hbmartin/usb-c-cable-bracelet-double-sided-connector/generated/v8/concepts.md

# #3F Compact tapered 15° right-angle press-fit (standard)

13.6 × 27.2 × 9.198 mm; tapered outer flanks; inverted 15° center bend.

Push each plug along its straight axis from opposite ends, with cable tails outward. The inverted 15° middle bend has −7.5° / +7.5° section rolls; insertion axes remain parallel. Capture 2 mm of black base, leaving 0.5 mm to the silver elbow.

Same local sockets and trial mouth fits as #3E Inverted, with a 13.6 mm body and tapered outer flanks. Reuse the straight fit samples; physical retention and wrist comfort require a print test.
