hbmartin/usb-c-cable-bracelet-double-sided-connector/generated/v6/concepts.md

# #3E 15° right-angle side-by-side press-fit

Measured plug: 8.10 × 2.30 × 8.40 mm metal; 9.90 × 4.70 × 2.50 mm black base.
2 mm base capture; 0.5 mm silver-elbow standoff; 11.2 mm blind pocket.
15° bend between lanes about X: pod rolls +7.5° / −7.5°; insertion axes remain parallel. Mirror cable tails outward.
Print on negative-X end, −90° Y; A1 / PLA / 0.4 / 0.20 mm / Textured PEI.
20% gyroid, 3 walls, 5 top/bottom layers, 1 mm shells, no supports.
One centered holder.
Test gentle first. Retention and durability require physical testing; stop if force or cracking occurs.

## #3E 15° right-angle side-by-side press-fit (standard)

Mouth: (9.6, 4.4) mm; dimensions: (14.6, 27.2, 9.198) mm.
STEP: `step/03e_right_angle_side_by_side_standard.step`; STL: `stl/03e_right_angle_side_by_side_standard.stl`.
