hbmartin/usb-c-cable-bracelet-double-sided-connector/generated/v3/concepts.md

# #3B 15° curved press-fit

Body: 24.0 × 17.0 × 9.777 mm. 15° total bend; each straight socket tilts 7.5°. The concave underside faces the wrist.

Finished centerline arc radius: 6.075 mm. Minimum central pocket separation: 1.201 mm.

The winning #3 mouth, cavity, 0.8 mm throat, relief slots, 10.8 mm pocket depth, and 3.2 mm housing capture are preserved in each socket's local frame.

Push each plug straight along its tilted socket axis toward the center. Wear with the concave underside toward the wrist.

Print on the flat long side: the original 17 mm width becomes print height. A1 / Generic PLA / 0.4 mm / 0.20 mm Standard / Textured PEI; supports disabled.

Physical acceptance: retain #3's fit, improve wrist seating, and show no central cracking or separation during insertion. Grip, comfort and fatigue require a physical print test.
