hbmartin/usb-c-cable-bracelet-double-sided-connector/generated/v5/concepts.md

# #3D 15° curved side-by-side press-fit

Body: 15.2 × 30.0 × 9.774 mm. Concave wrist face, convex outer face; local radial thickness 9.4 mm.

Centerline radius: 53.901 mm. Socket lanes: ±6.5 mm; 7.5° tilt each, 15° total. The sockets remain straight and open from opposite ends.

Wear the concave underside toward the wrist. Push each plug straight along its own 7.5° tilted axis; the two offset sockets open from opposite ends.

Reference #3 fit: metal 8.65 × 2.95 mm; housing 12.20 × 6.60 mm; mouth 11.25 × 5.65 mm; 10.8 mm blind pocket, 3.2 mm capture, 0.8 mm nominal throat with 0.15 mm overlap, and unchanged 0.8 mm relief slots. All dimensions are measured in the socket's local frame.

Minimum inter-lane void separation: 1.225 mm; enclosed wall: 0.800 mm; closed end wall: 3.137 mm.

Print on the flat negative-X end face, rotated −82.5° about Y. Center: (128,128) mm. A1 / Generic PLA / 0.4 mm / 0.20 mm Standard / Textured PEI; no supports; 20% gyroid, 3 walls, 5 top and bottom layers with 1 mm shell thickness.

Physical acceptance: both plugs retain #3's usable fit independently, the curve seats comfortably on the wrist, and insertion causes no cracking or separation. These require a physical print test.
