hbmartin/usb-c-cable-bracelet-double-sided-connector/generated/v6/fit_samples/concepts.md

# #3E right-angle plug fit samples

Measured plug: 8.10 × 2.30 × 8.40 mm metal; 9.90 × 4.70 × 2.50 mm black base.
2 mm base capture; 0.5 mm silver-elbow standoff; 11.2 mm blind pocket.
Straight single-socket fit blocks.
Print on negative-X end, −90° Y; A1 / PLA / 0.4 / 0.20 mm / Textured PEI.
20% gyroid, 3 walls, 5 top/bottom layers, 1 mm shells, no supports.
Samples left to right: gentle, standard, firm; 12 mm gaps.
Test gentle first. Retention and durability require physical testing; stop if force or cracking occurs.

## #3E gentle fit sample

Mouth: (9.75, 4.55) mm; dimensions: (14.6, 14.4, 7.6) mm.
STEP: `step/03e_fit_sample_gentle.step`; STL: `stl/03e_fit_sample_gentle.stl`.

## #3E standard fit sample

Mouth: (9.6, 4.4) mm; dimensions: (14.6, 14.4, 7.6) mm.
STEP: `step/03e_fit_sample_standard.step`; STL: `stl/03e_fit_sample_standard.stl`.

## #3E firm fit sample

Mouth: (9.45, 4.25) mm; dimensions: (14.6, 14.4, 7.6) mm.
STEP: `step/03e_fit_sample_firm.step`; STL: `stl/03e_fit_sample_firm.stl`.
