hbmartin/usb-c-cable-bracelet-double-sided-connector/generated/all_connectors_preview.png

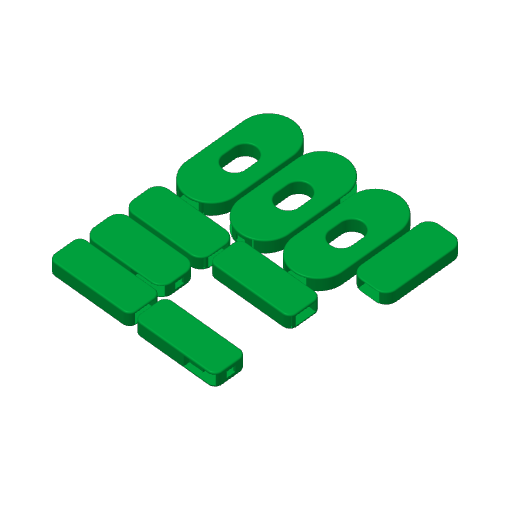
generated/all_connectors_preview.png
