hbmartin/usb-c-cable-bracelet-double-sided-connector/generated/v8/bend_section.png

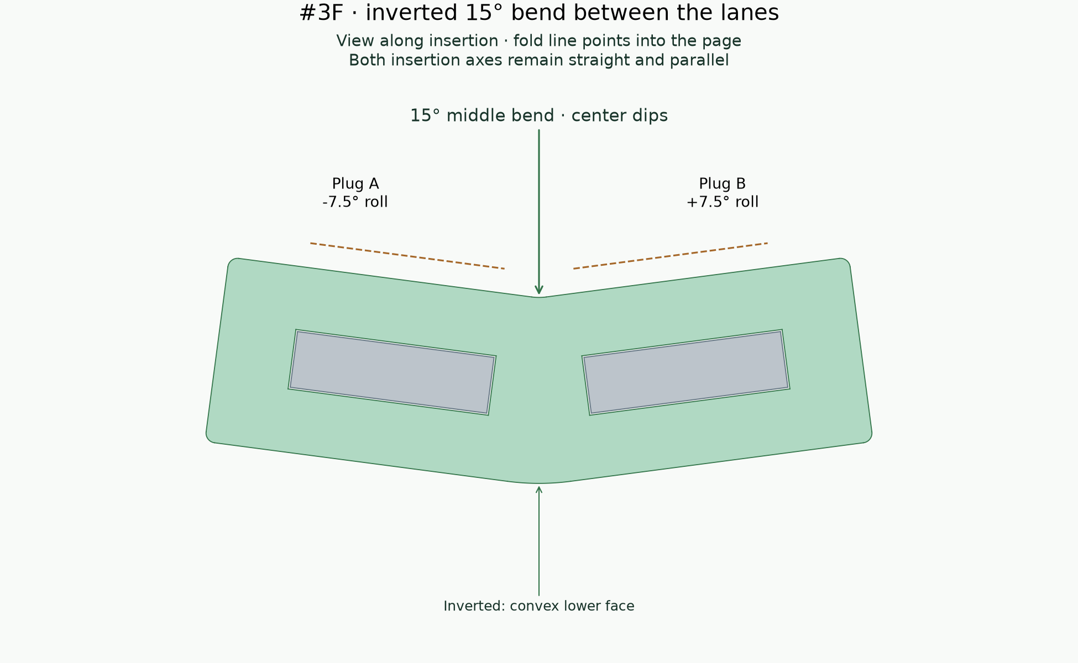
generated/v8/bend_section.png
