hbmartin/usb-c-cable-bracelet-double-sided-connector/generated/v8/comparison.png

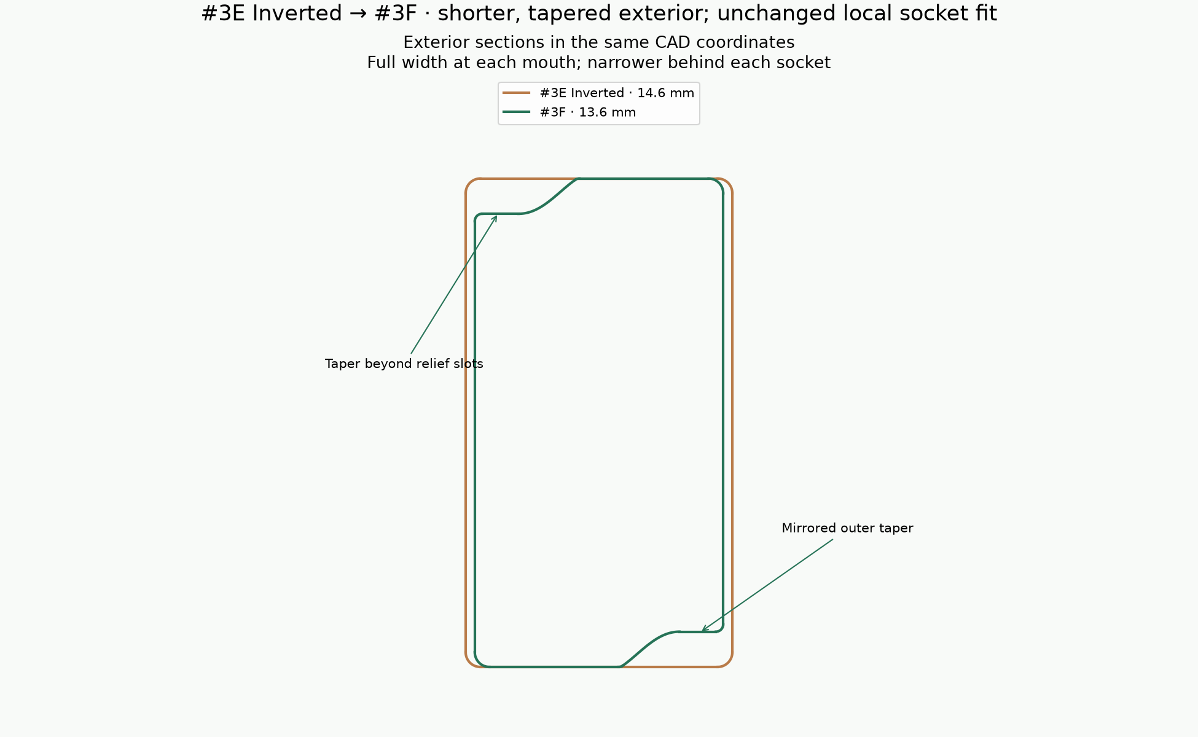
generated/v8/comparison.png
