hbmartin/usb-c-cable-bracelet-double-sided-connector/generated/v8/layer_paths.png

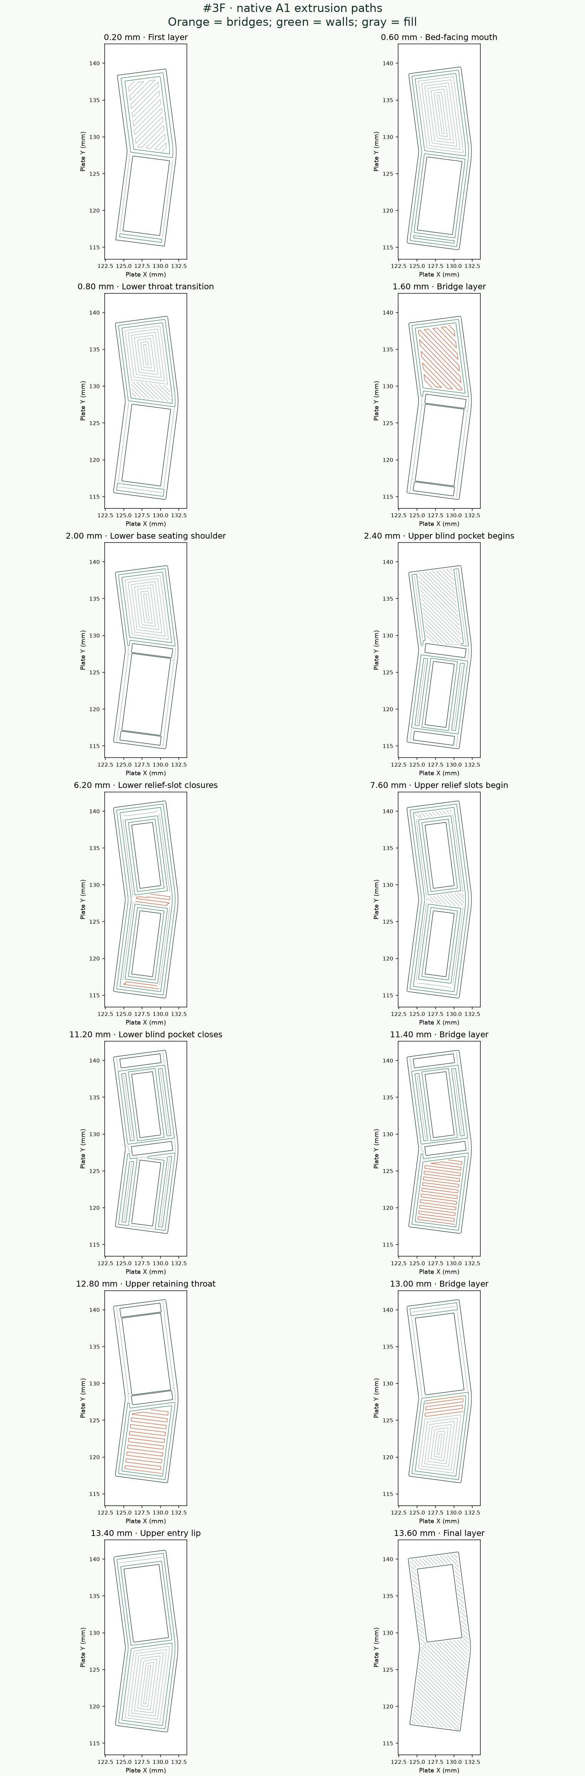
generated/v8/layer_paths.png
