hbmartin/usb-c-cable-bracelet-double-sided-connector/generated/v8/plate_map.png

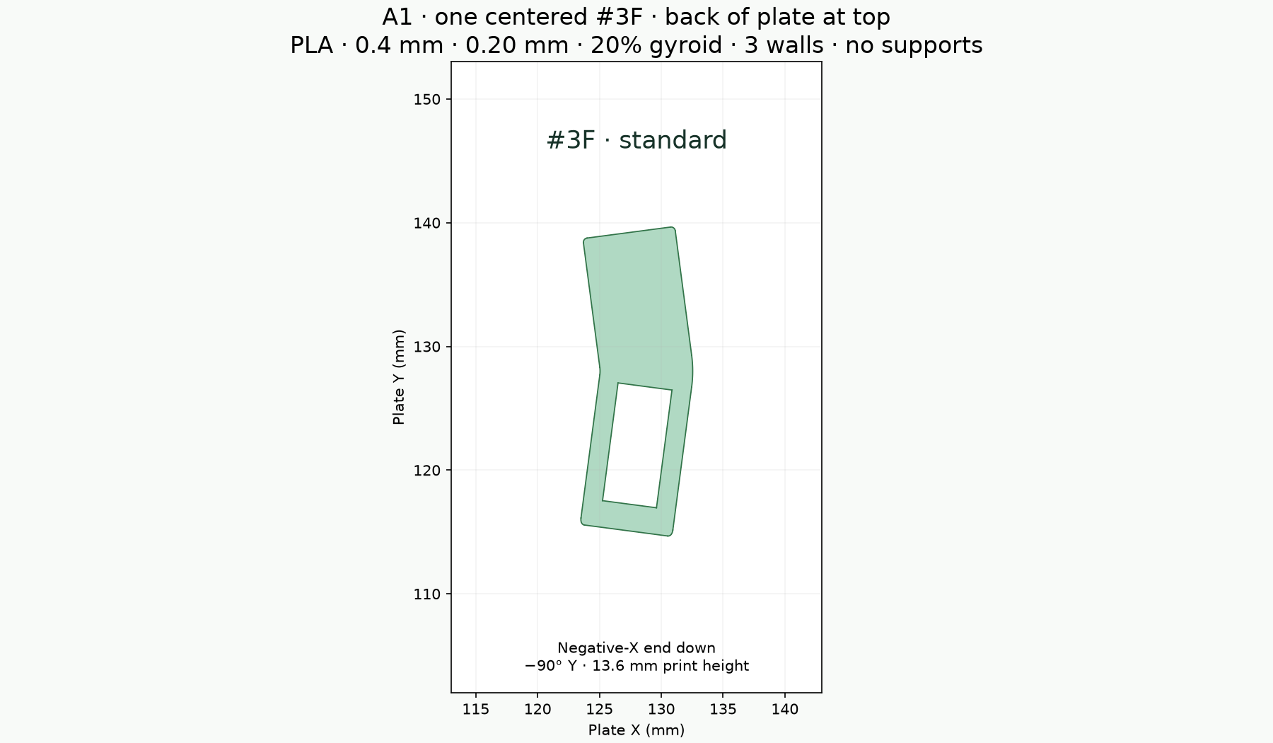
generated/v8/plate_map.png
