hbmartin/usb-c-cable-bracelet-double-sided-connector/generated/v8/preview.png

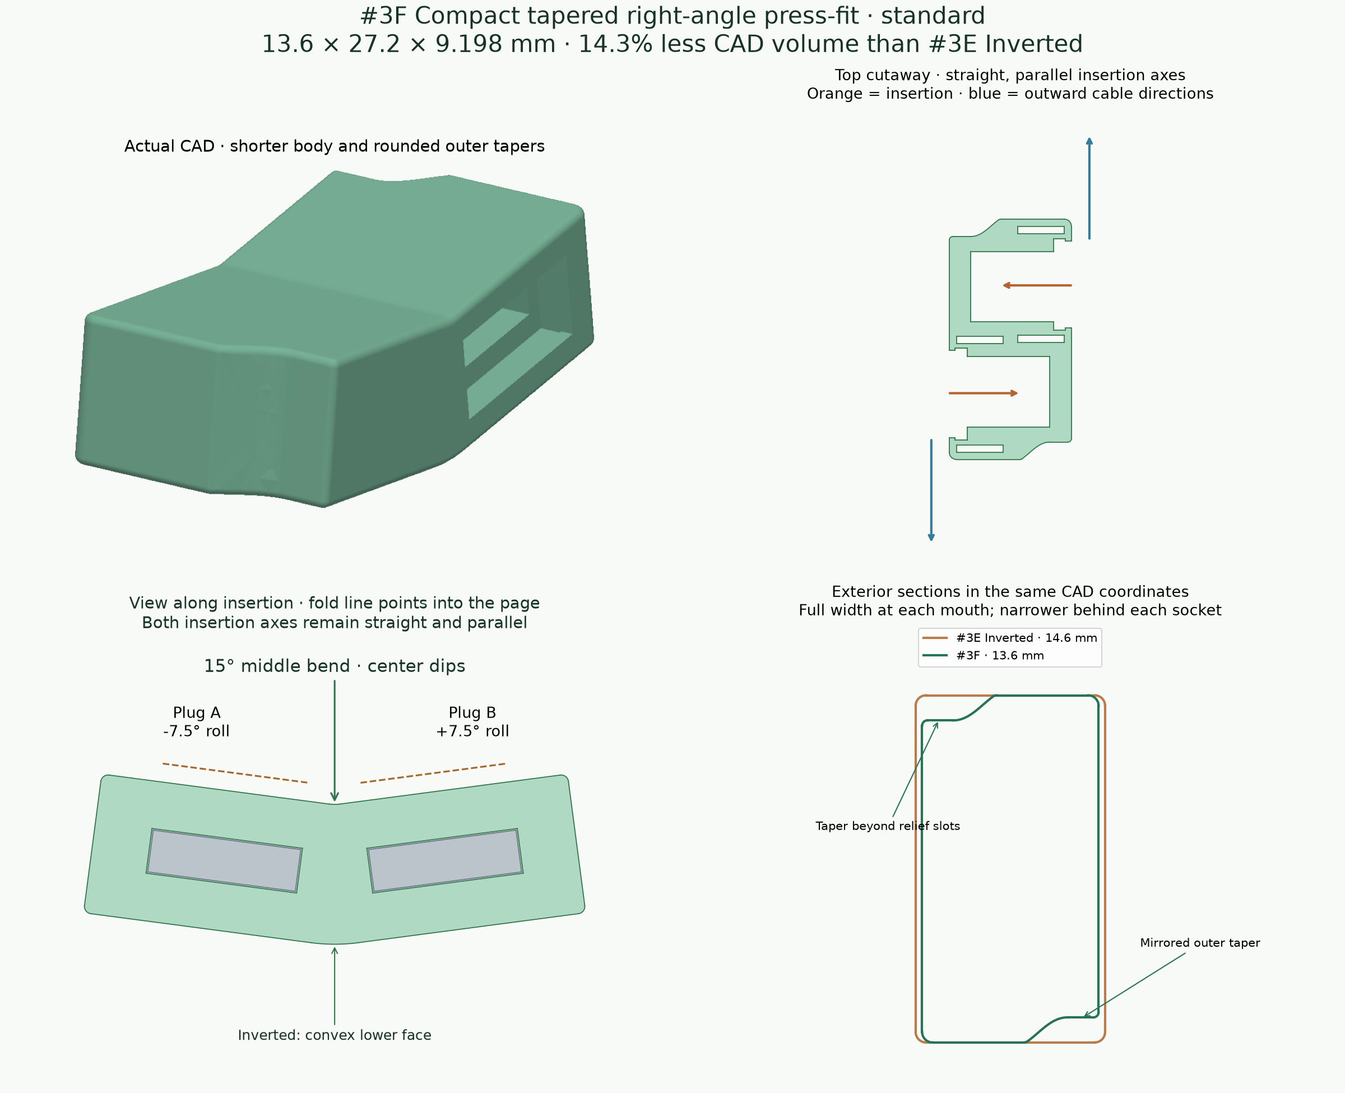
generated/v8/preview.png
