hbmartin/usb-c-cable-bracelet-double-sided-connector/generated/v8/side_sections.png

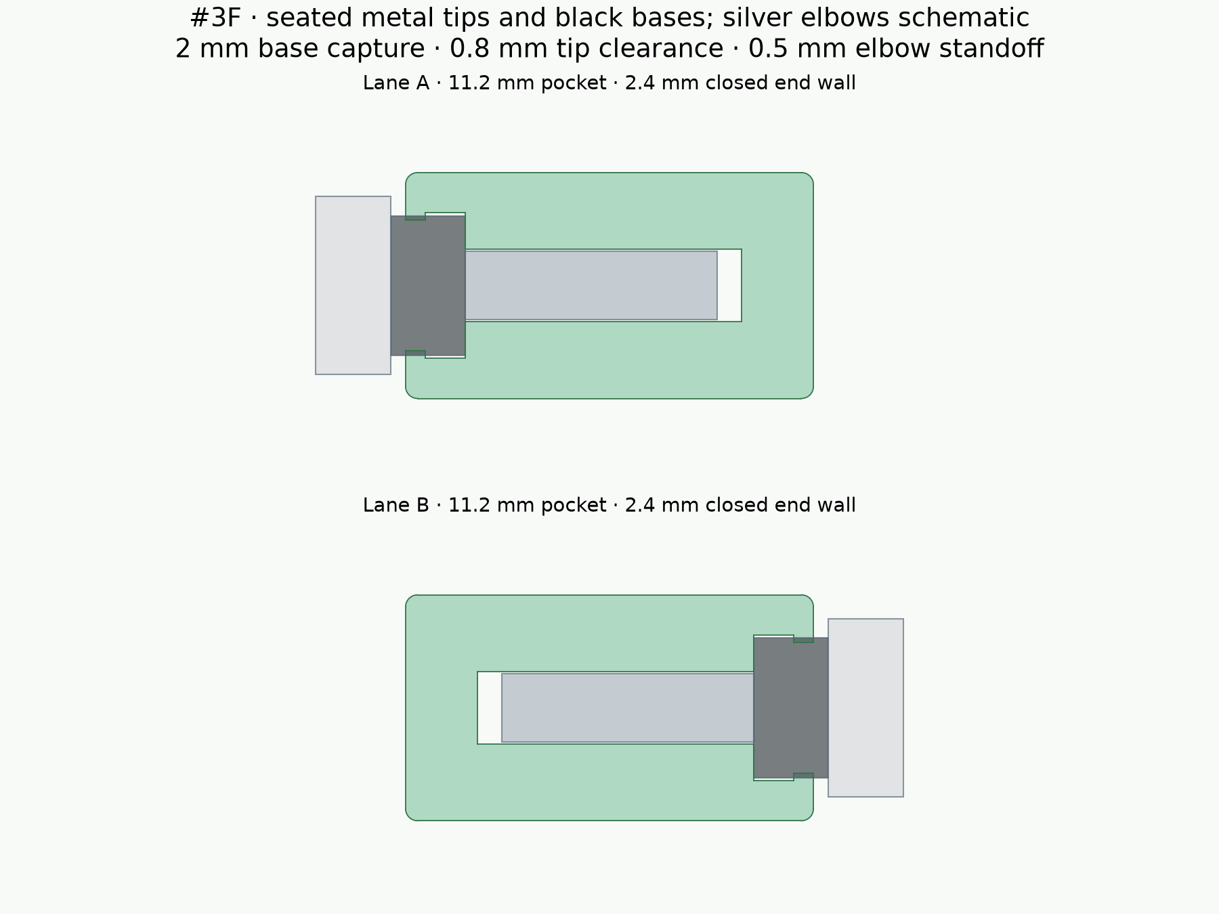
generated/v8/side_sections.png
