hbmartin/usb-c-cable-bracelet-double-sided-connector/generated/all_connectors_A1_PLA.3mf

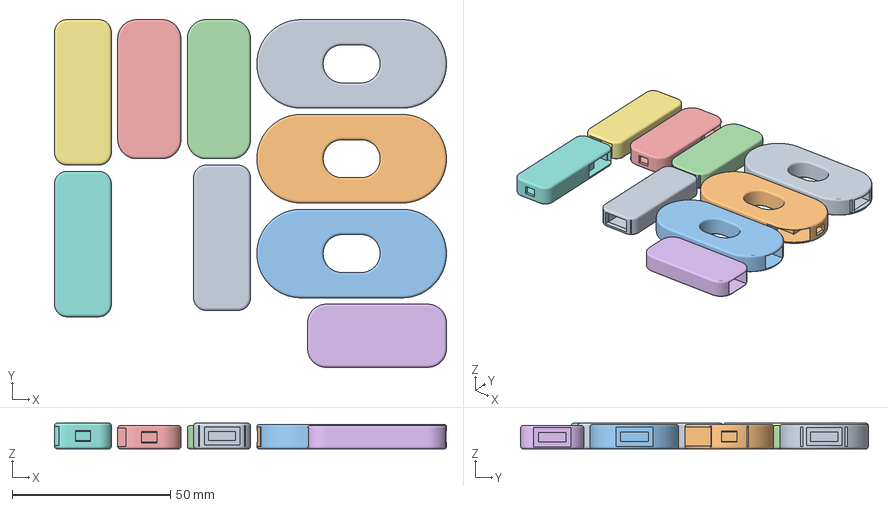
[picture p9: CAD file, 2026-10-17]
generated/all_connectors_A1_PLA.3mf
124.0 x 110.0 x 8.20 mm
oval_ring_press_fit.stl
oval_ring_side_entry.stl
oval_ring_push_socket.stl
flat_tab_press_fit.stl
flat_tab_side_entry.stl
flat_tab_push_socket.stl
straight_bar_push_socket.stl
straight_bar_side_entry.stl
straight_bar_press_fit.stl
