hbmartin/usb-c-cable-bracelet-double-sided-connector/generated/comparison_3B_3C/connectors_3B_3C_A1_PLA.3mf

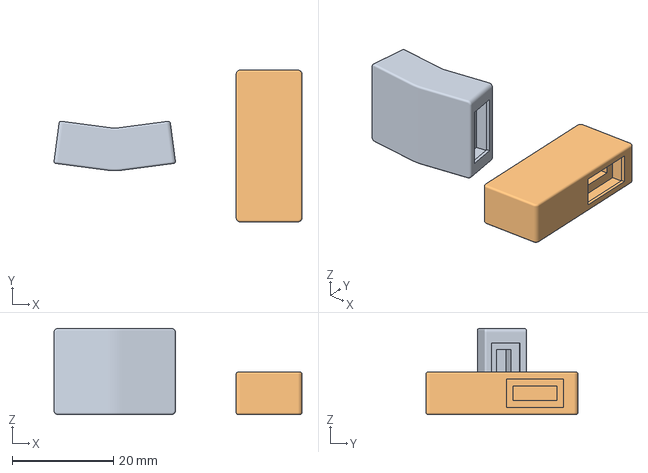
[picture p10: CAD file, 2026-10-18]
generated/comparison_3B_3C/connectors_3B_3C_A1_PLA.3mf
49.0 x 30.0 x 17.0 mm
#3B 15° curved press-fit
#3C Side-by-side press-fit
