hbmartin/usb-c-cable-bracelet-double-sided-connector/generated/step/oval_ring_side_entry.step

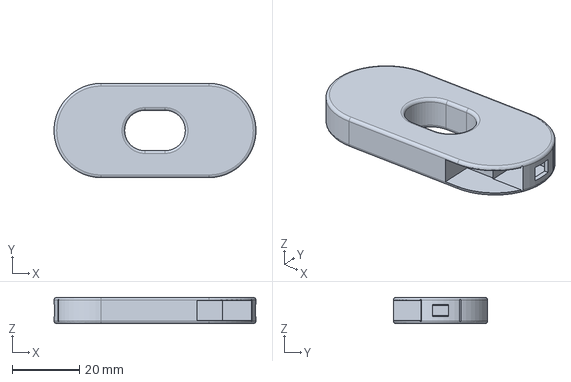
[picture p11: CAD file, 2026-07-07]
generated/step/oval_ring_side_entry.step
60.0 x 28.0 x 7.80 mm
