hbmartin/usb-c-cable-bracelet-double-sided-connector/generated/v6_original_axis/fit_samples/right_angle_fit_samples_A1_PLA.3mf

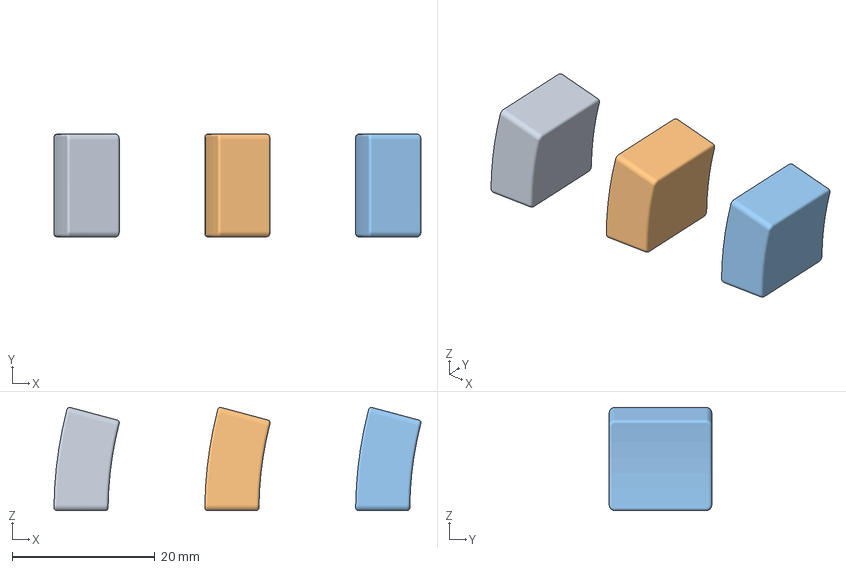
[picture p12: CAD file, 2026-10-21]
generated/v6_original_axis/fit_samples/right_angle_fit_samples_A1_PLA.3mf
51.5 x 14.4 x 14.5 mm
#3E gentle fit sample
#3E standard fit sample
#3E firm fit sample
