hbmartin/usb-c-cable-bracelet-double-sided-connector/generated/v6_original_axis/fit_samples/step/03e_fit_sample_gentle.step

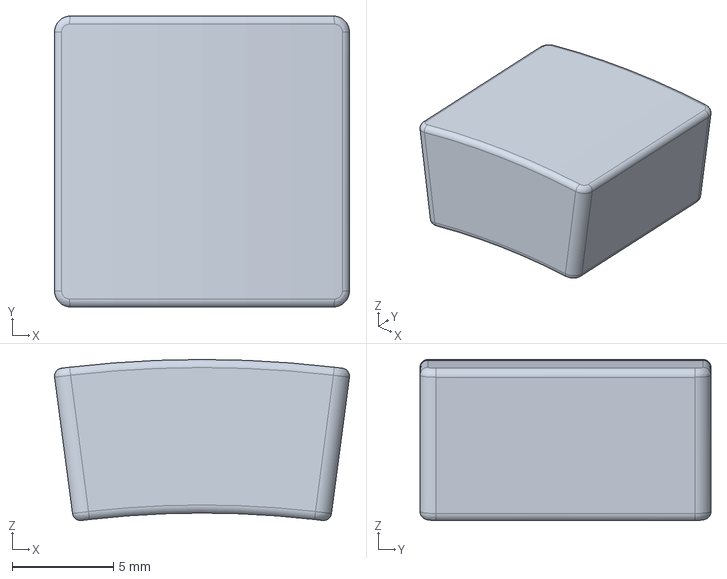
[picture p13: CAD file, 2026-10-21]
generated/v6_original_axis/fit_samples/step/03e_fit_sample_gentle.step
14.6 x 14.4 x 7.97 mm
