hbmartin/usb-c-cable-bracelet-double-sided-connector/generated/v6_original_axis/right_angle_press_fit_3E_A1_PLA.3mf

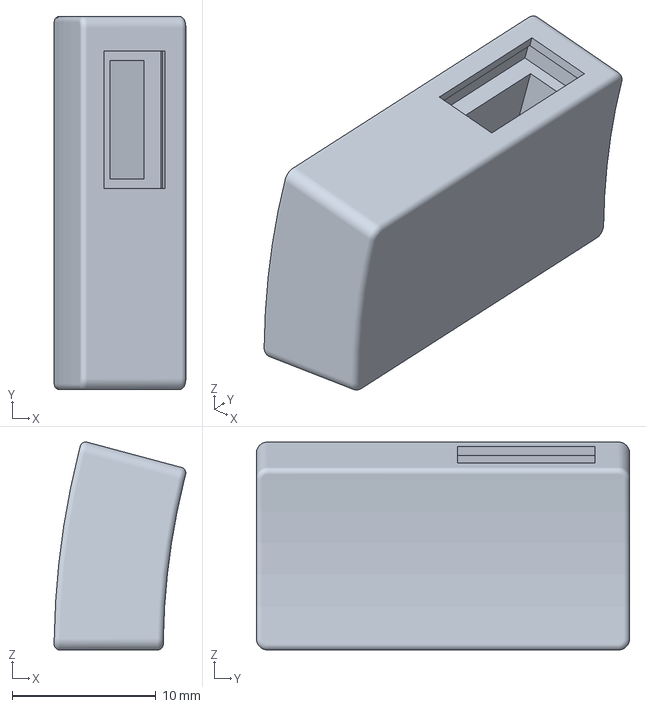
[picture p14: CAD file, 2026-10-21]
generated/v6_original_axis/right_angle_press_fit_3E_A1_PLA.3mf
9.17 x 26.0 x 14.5 mm
