hbmartin/usb-c-cable-bracelet-double-sided-connector/generated/v6_original_axis/step/03e_right_angle_side_by_side_standard.step

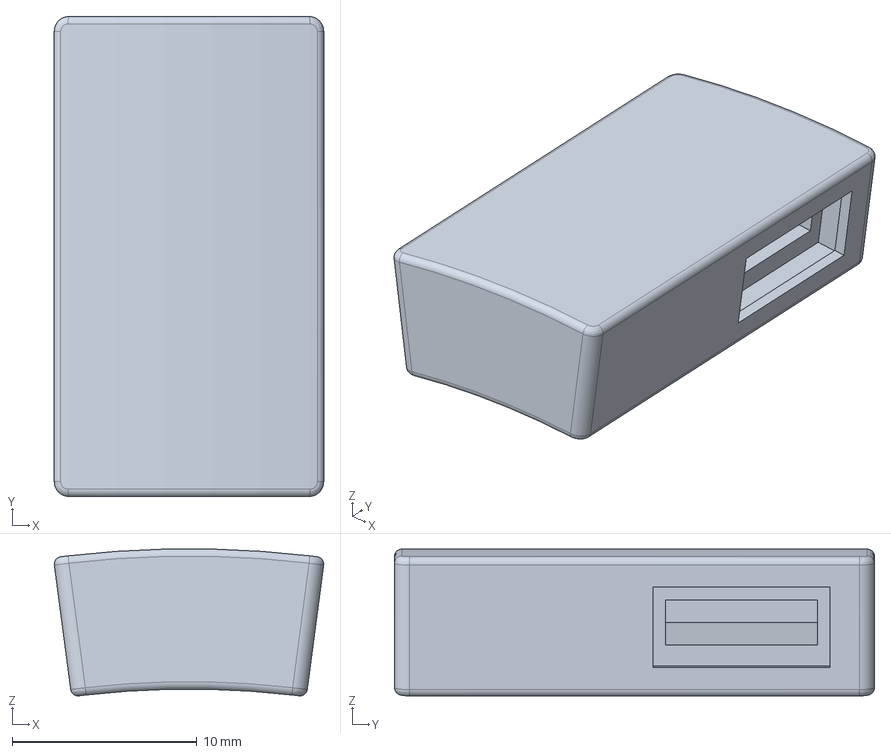
[picture p15: CAD file, 2026-10-21]
generated/v6_original_axis/step/03e_right_angle_side_by_side_standard.step
14.6 x 26.0 x 7.95 mm
