hbmartin/usb-c-cable-bracelet-double-sided-connector/generated/v8/compact_tapered_press_fit_3F_A1_PLA.3mf

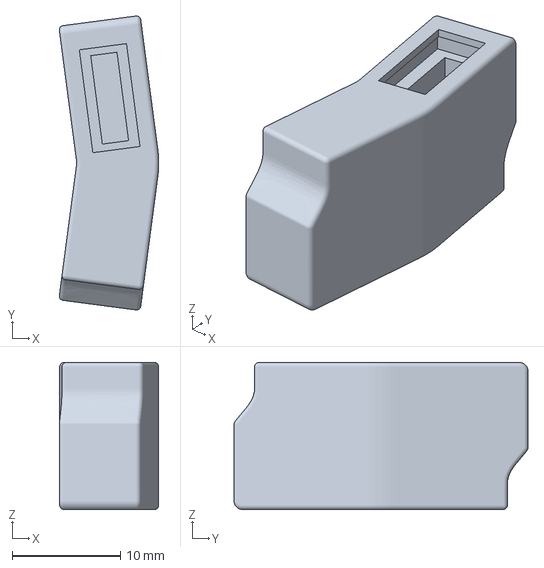
[picture p16: CAD file, 2026-11-08]
generated/v8/compact_tapered_press_fit_3F_A1_PLA.3mf
9.20 x 27.2 x 13.6 mm
