hbmartin/usb-c-cable-bracelet-double-sided-connector/generated/step/straight_bar_push_socket.step

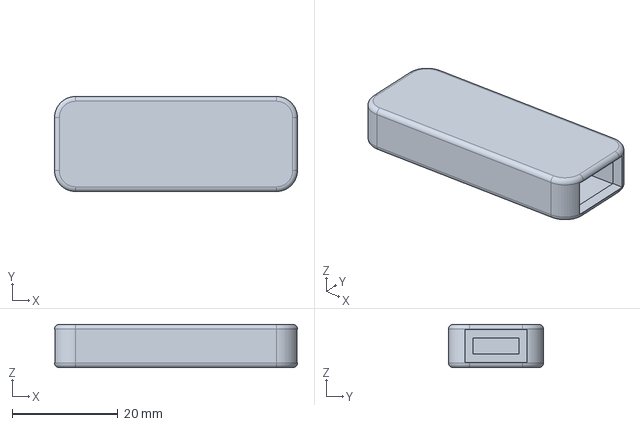
[picture p17: CAD file, 2026-07-07]
generated/step/straight_bar_push_socket.step
46.0 x 18.0 x 8.20 mm
