hbmartin/usb-c-cable-bracelet-double-sided-connector/generated/step/flat_tab_press_fit.step

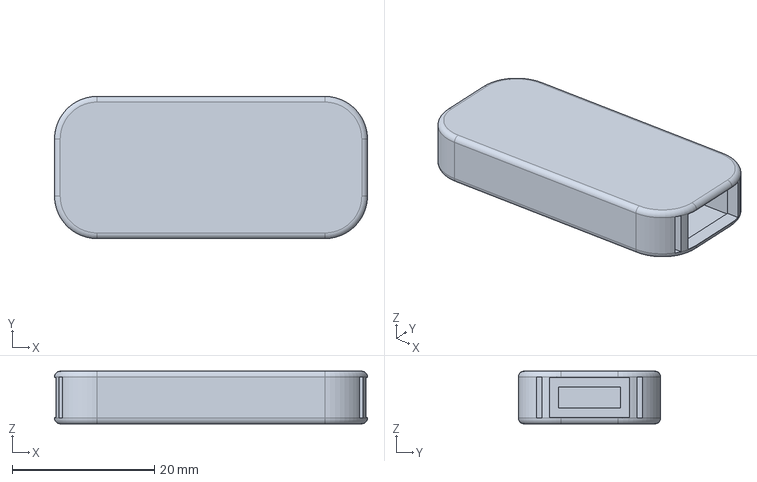
[picture p18: CAD file, 2026-07-07]
generated/step/flat_tab_press_fit.step
44.0 x 20.0 x 7.40 mm
