hbmartin/usb-c-cable-bracelet-double-sided-connector/generated/step/flat_tab_side_entry.step

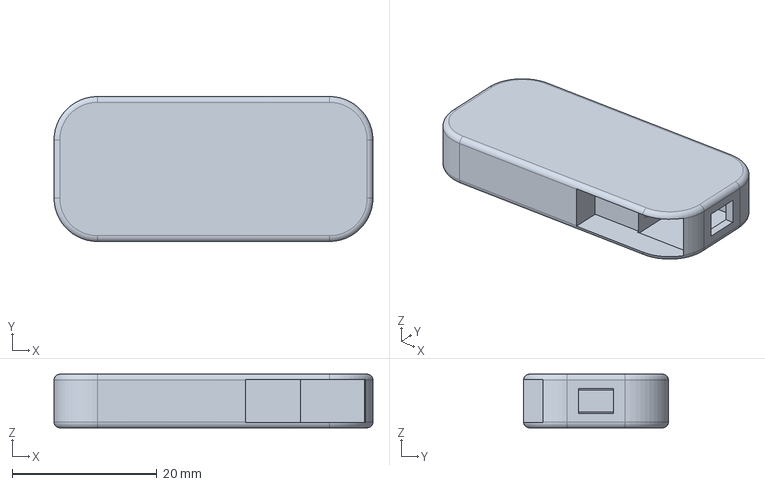
[picture p19: CAD file, 2026-07-07]
generated/step/flat_tab_side_entry.step
44.0 x 20.0 x 7.40 mm
