hbmartin/usb-c-cable-bracelet-double-sided-connector/generated/step/flat_tab_push_socket.step

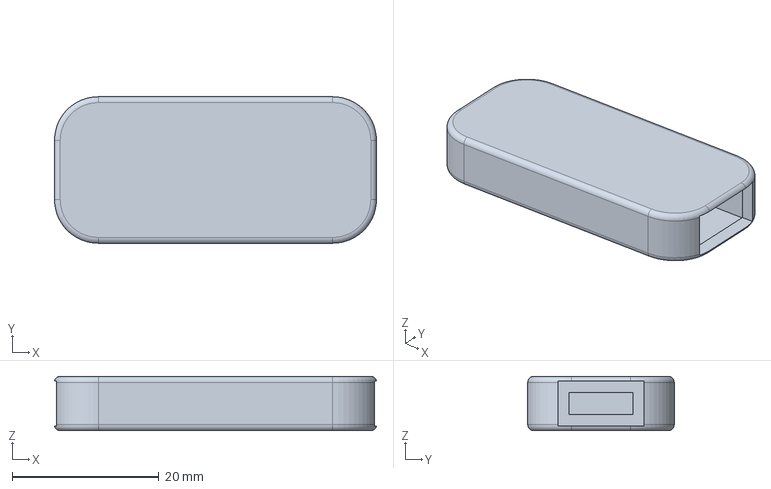
[picture p20: CAD file, 2026-07-07]
generated/step/flat_tab_push_socket.step
43.9 x 20.0 x 7.40 mm
