hbmartin/usb-c-cable-bracelet-double-sided-connector/generated/step/oval_ring_push_socket.step

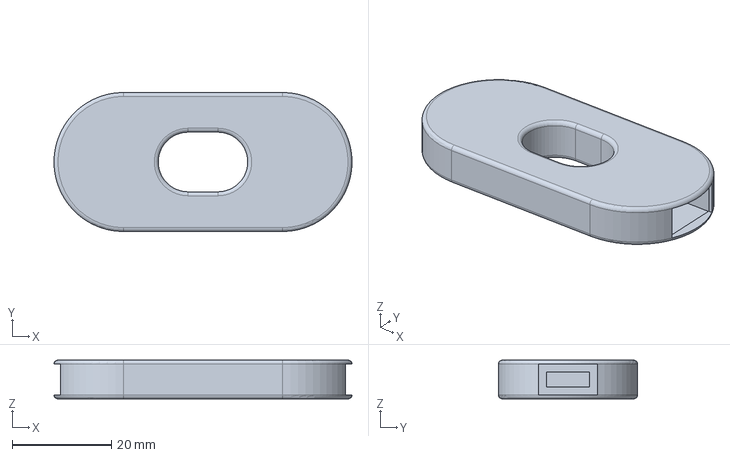
[picture p22: CAD file, 2026-07-07]
generated/step/oval_ring_push_socket.step
60.0 x 28.0 x 7.80 mm
