hbmartin/usb-c-cable-bracelet-double-sided-connector/generated/step/straight_bar_press_fit.step

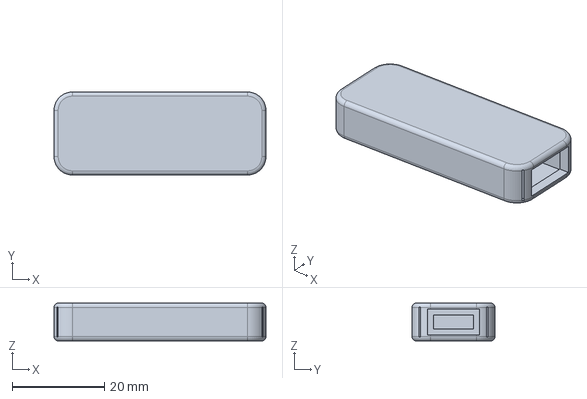
[picture p23: CAD file, 2026-07-07]
generated/step/straight_bar_press_fit.step
46.0 x 18.0 x 8.20 mm
