hbmartin/usb-c-cable-bracelet-double-sided-connector/generated/step/straight_bar_side_entry.step

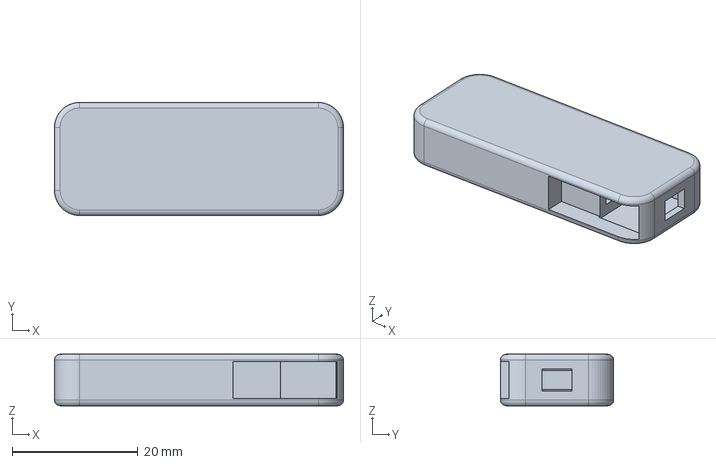
[picture p24: CAD file, 2026-07-07]
generated/step/straight_bar_side_entry.step
46.0 x 18.0 x 8.20 mm
