hbmartin/usb-c-cable-bracelet-double-sided-connector/(list of files, cad)

Other CAD files:
generated/v8/step/03f_compact_tapered_right_angle_standard.step
generated/all_connectors_A1.3mf
generated/v6_original_axis/fit_samples/step/03e_fit_sample_standard.step
generated/all_connectors.3mf
generated/v6_original_axis/fit_samples/step/03e_fit_sample_firm.step
generated/stl/flat_tab_press_fit.stl
generated/stl/flat_tab_push_socket.stl
generated/stl/flat_tab_side_entry.stl
generated/stl/oval_ring_press_fit.stl
generated/stl/oval_ring_push_socket.stl
generated/stl/oval_ring_side_entry.stl
generated/stl/straight_bar_press_fit.stl
generated/stl/straight_bar_push_socket.stl
generated/stl/straight_bar_side_entry.stl
generated/v2/compact_connectors_A1_PLA.3mf
generated/v2/step/03_compact_press_fit.step
generated/v2/step/05_compact_side_entry.step
generated/v2/step/09_compact_ribbed_push_in.step
generated/v2/stl/03_compact_press_fit.stl
generated/v2/stl/05_compact_side_entry.stl
generated/v2/stl/09_compact_ribbed_push_in.stl
generated/v3/curved_press_fit_3B_A1_PLA.3mf
generated/v3/step/03b_curved_press_fit_15deg.step
generated/v3/stl/03b_curved_press_fit_15deg.stl
generated/v4/side_by_side_press_fit_3C_A1_PLA.3mf
generated/v4/step/03c_side_by_side_press_fit.step
generated/v4/stl/03c_side_by_side_press_fit.stl
generated/v5/curved_side_by_side_press_fit_3D_A1_PLA.3mf
generated/v5/curved_side_by_side_press_fit_3D_A1_PLA_preserved_2026-10-18.3mf
generated/v5/step/03d_curved_side_by_side_press_fit_15deg.step
generated/v5/stl/03d_curved_side_by_side_press_fit_15deg.stl
generated/v6/combined_plate/corrected_3E_and_fit_samples_A1_PLA.3mf
generated/v6/fit_samples/right_angle_fit_samples_A1_PLA.3mf
generated/v6/fit_samples/step/03e_fit_sample_firm.step
generated/v6/fit_samples/step/03e_fit_sample_gentle.step
generated/v6/fit_samples/step/03e_fit_sample_standard.step
generated/v6/fit_samples/stl/03e_fit_sample_firm.stl
generated/v6/fit_samples/stl/03e_fit_sample_gentle.stl
generated/v6/fit_samples/stl/03e_fit_sample_standard.stl
generated/v6/right_angle_press_fit_3E_A1_PLA.3mf
generated/v6/step/03e_right_angle_side_by_side_standard.step
generated/v6/stl/03e_right_angle_side_by_side_standard.stl
generated/v6_original_axis/fit_samples/stl/03e_fit_sample_firm.stl
generated/v6_original_axis/fit_samples/stl/03e_fit_sample_gentle.stl
generated/v6_original_axis/fit_samples/stl/03e_fit_sample_standard.stl
generated/v6_original_axis/stl/03e_right_angle_side_by_side_standard.stl
generated/v7/right_angle_press_fit_3E_inverted_A1_PLA.3mf
generated/v7/step/03e_inverted_right_angle_side_by_side_standard.step
generated/v7/stl/03e_inverted_right_angle_side_by_side_standard.stl
generated/v8/stl/03f_compact_tapered_right_angle_standard.stl
