hbmartin/usb-c-cable-bracelet-double-sided-connector/generated/v8/print_notes.md

# #3F Compact tapered right-angle press-fit

One centered standard-fit holder, based on inverted #3E. Body: 13.6 × 27.2 × 9.198 mm.
Print negative-X end down, −90° about Y, at 13.6 mm height.

A1 / Generic PLA / 0.4 mm nozzle / 0.20 mm Standard / Textured PEI.
20% gyroid, three walls, five top and bottom layers, 1 mm shells, supports disabled.
Explicit Studio override metadata is included. Open the editable 3MF and Slice plate.

Native slice: 18 min 31 sec, 2.4 g PLA, 68 layers; no warnings, support paths,
floating islands, blocked socket cores, or unanchored bridges. All 180 core probes pass.

Keep the right-angle cable tails outward. Insert and withdraw along the straight,
parallel socket axes. Reuse the straight #3E fit samples; all three mouth fits are available.
Physical fit, independent retention, wrist comfort, and durability still need a print test.
Project preparation does not start a physical print.
