hbmartin/usb-c-cable-bracelet-double-sided-connector/generated/v6/print_notes.md

# Corrected #3E A1 print notes

One standard-fit holder with the **15° bend in the bridge between the plug lanes**. Pod wide faces roll +7.5° / −7.5° about X; insertion axes remain parallel and open at opposite ends. Use the concave face against the wrist and mirror cable tails outward.

Print on the flat negative-X end face, rotated −90° about Y. A1 / Generic PLA / 0.4 mm / 0.20 mm Standard / Textured PEI. 20% gyroid, three walls, five top/bottom layers, 1 mm shells, supports disabled.

Native slice: 19.3 minutes, 2.68 g PLA, 73 layers. No warnings, support toolpaths, floating islands or blocked socket-core probes.

Open the editable 3MF and click Slice plate in Bambu Studio; it has no cached G-code. The separately saved G-code is the native validation slice. No physical print was started.

Fit, retention, comfort and durability require physical testing. Start with gentle; stop if force, damage or cracking occurs. Initial wrong-axis #3E exports are preserved under generated/v6_original_axis/ for comparison.
