hbmartin/usb-c-cable-bracelet-double-sided-connector/generated/v6/combined_plate/print_notes.md

# Corrected #3E and three fit samples

Left to right: **1 corrected #3E holder (standard fit), 2 gentle sample, 3 standard sample, 4 firm sample**. One of each; 12 mm gaps. The holder has the 15° bend between the lanes, with parallel insertion axes.

All four print by layer on the flat negative-X end, rotated −90° about Y. A1 / Generic PLA / 0.4 mm / 0.20 mm Standard / Textured PEI. 20% gyroid, three walls, five top/bottom layers, 1 mm shells, supports disabled.

Native slice: 28.6 minutes, 7.03 g PLA, 73 layers. No warnings, support paths, floating islands or blocked socket-core probes.

Open the editable 3MF in Bambu Studio and click Slice plate; it contains no cached G-code. Test the gentle sample first. No physical print was started.
