hbmartin/usb-c-cable-bracelet-double-sided-connector/generated/v8/test_results.txt

test_center_arc_meets_both_straight_body_sections_tangentially (test_curved.CurvedGeometryTests.test_center_arc_meets_both_straight_body_sections_tangentially) ... ok
test_curved_exports_have_independent_defaults_and_respect_skip_flags (test_curved.CurvedGeometryTests.test_curved_exports_have_independent_defaults_and_respect_skip_flags) ... ok
test_delivered_curved_print_archive (test_curved.CurvedGeometryTests.test_delivered_curved_print_archive) ... ok
test_metal_tip_can_follow_each_entire_straight_insertion_path (test_curved.CurvedGeometryTests.test_metal_tip_can_follow_each_entire_straight_insertion_path) ... ok
test_nominal_roof_floor_and_solid_curved_center (test_curved.CurvedGeometryTests.test_nominal_roof_floor_and_solid_curved_center) ... ok
test_original_models_match_preserved_step_geometry (test_curved.CurvedGeometryTests.test_original_models_match_preserved_step_geometry) ... ok
test_pockets_have_solid_divider_and_unchanged_depth (test_curved.CurvedGeometryTests.test_pockets_have_solid_divider_and_unchanged_depth) ... ok
test_proven_socket_dimensions_in_both_local_frames (test_curved.CurvedGeometryTests.test_proven_socket_dimensions_in_both_local_frames) ... ok
test_side_orientation_is_centered_and_on_the_bed (test_curved.CurvedGeometryTests.test_side_orientation_is_centered_and_on_the_bed) ... ok
test_straight_socket_axes_have_fifteen_degree_total_bend (test_curved.CurvedGeometryTests.test_straight_socket_axes_have_fifteen_degree_total_bend) ... ok
test_valid_single_solid_and_finished_dimensions (test_curved.CurvedGeometryTests.test_valid_single_solid_and_finished_dimensions) ... ok
test_continuous_metal_insertion_sweep_and_seated_housings_are_clear (test_curved_side_by_side.CurvedSideBySideGeometryTests.test_continuous_metal_insertion_sweep_and_seated_housings_are_clear) ... ok
test_custom_output_and_skip_flags_include_illustrations_and_validation (test_curved_side_by_side.CurvedSideBySideGeometryTests.test_custom_output_and_skip_flags_include_illustrations_and_validation) ... ok
test_end_face_print_orientation_is_centered_flat_and_on_bed (test_curved_side_by_side.CurvedSideBySideGeometryTests.test_end_face_print_orientation_is_centered_flat_and_on_bed) ... ok
test_independent_blind_pockets_and_material_at_all_required_minimums (test_curved_side_by_side.CurvedSideBySideGeometryTests.test_independent_blind_pockets_and_material_at_all_required_minimums) ... ok
test_native_project_closed_stl_print_settings_and_unblocked_toolpaths (test_curved_side_by_side.CurvedSideBySideGeometryTests.test_native_project_closed_stl_print_settings_and_unblocked_toolpaths) ... ok
test_previous_side_by_side_model_and_defaults_are_preserved (test_curved_side_by_side.CurvedSideBySideGeometryTests.test_previous_side_by_side_model_and_defaults_are_preserved) ... ok
test_project_rejects_strength_overrides_that_studio_would_drop (test_curved_side_by_side.CurvedSideBySideGeometryTests.test_project_rejects_strength_overrides_that_studio_would_drop) ... ok
test_single_valid_solid_and_curved_faces_at_selected_dimensions (test_curved_side_by_side.CurvedSideBySideGeometryTests.test_single_valid_solid_and_curved_faces_at_selected_dimensions) ... ok
test_straight_axes_are_offset_thirteen_mm_and_counter_tilted_fifteen_degrees (test_curved_side_by_side.CurvedSideBySideGeometryTests.test_straight_axes_are_offset_thirteen_mm_and_counter_tilted_fifteen_degrees) ... ok
test_toolpath_probe_detects_a_blocked_bed_facing_mouth (test_curved_side_by_side.CurvedSideBySideGeometryTests.test_toolpath_probe_detects_a_blocked_bed_facing_mouth) ... ok
test_winning_socket_sizes_throat_overlap_and_relief_slots_in_both_frames (test_curved_side_by_side.CurvedSideBySideGeometryTests.test_winning_socket_sizes_throat_overlap_and_relief_slots_in_both_frames) ... ok
test_delivered_archive_contains_only_the_three_revisions_and_no_stale_toolpaths (test_geometry.CompactGeometryTests.test_delivered_archive_contains_only_the_three_revisions_and_no_stale_toolpaths) ... ok
test_existing_skip_flags_allow_manifest_only_generation (test_geometry.CompactGeometryTests.test_existing_skip_flags_allow_manifest_only_generation) ... ok
test_minimum_roof_and_floor_at_all_cut_features (test_geometry.CompactGeometryTests.test_minimum_roof_and_floor_at_all_cut_features) ... ok
test_original_tip_clearances_remain_smooth (test_geometry.CompactGeometryTests.test_original_tip_clearances_remain_smooth) ... ok
test_pocket_depth_and_solid_central_divider (test_geometry.CompactGeometryTests.test_pocket_depth_and_solid_central_divider) ... ok
test_press_fit_preserves_reference_mouth_and_housing (test_geometry.CompactGeometryTests.test_press_fit_preserves_reference_mouth_and_housing) ... ok
test_ribs_are_on_housing_faces_and_have_requested_extent (test_geometry.CompactGeometryTests.test_ribs_are_on_housing_faces_and_have_requested_extent) ... ok
test_side_entry_tip_can_load_but_cannot_exit_laterally_when_seated (test_geometry.CompactGeometryTests.test_side_entry_tip_can_load_but_cannot_exit_laterally_when_seated) ... ok
test_three_valid_single_bodies_at_requested_dimensions (test_geometry.CompactGeometryTests.test_three_valid_single_bodies_at_requested_dimensions) ... ok
test_actual_socket_axes_are_parallel_and_wide_faces_roll_fifteen_degrees (test_right_angle.RightAngleGeometryTests.test_actual_socket_axes_are_parallel_and_wide_faces_roll_fifteen_degrees) ... ok
test_all_fits_export_closed_two_manifold_meshes (test_right_angle.RightAngleGeometryTests.test_all_fits_export_closed_two_manifold_meshes) ... ok
test_all_profiles_differ_only_in_the_retaining_throat (test_right_angle.RightAngleGeometryTests.test_all_profiles_differ_only_in_the_retaining_throat) ... ok
test_all_six_models_are_valid_with_required_dimensions_and_material (test_right_angle.RightAngleGeometryTests.test_all_six_models_are_valid_with_required_dimensions_and_material) ... ok
test_both_native_projects_settings_meshes_and_unblocked_toolpaths (test_right_angle.RightAngleGeometryTests.test_both_native_projects_settings_meshes_and_unblocked_toolpaths) ... ok
test_cavities_and_relief_slots_in_each_socket_local_frame (test_right_angle.RightAngleGeometryTests.test_cavities_and_relief_slots_in_each_socket_local_frame) ... ok
test_cli_fit_custom_output_and_existing_skip_flags (test_right_angle.RightAngleGeometryTests.test_cli_fit_custom_output_and_existing_skip_flags) ... ok
test_combined_native_project_has_four_objects_and_all_five_sockets_clear (test_right_angle.RightAngleGeometryTests.test_combined_native_project_has_four_objects_and_all_five_sockets_clear) ... ok
test_combined_plate_uses_corrected_sources_in_order_with_twelve_mm_gaps (test_right_angle.RightAngleGeometryTests.test_combined_plate_uses_corrected_sources_in_order_with_twelve_mm_gaps) ... ok
test_elbow_clearance_is_proven_against_whole_body_half_spaces (test_right_angle.RightAngleGeometryTests.test_elbow_clearance_is_proven_against_whole_body_half_spaces) ... ok
test_existing_envelope_defaults_models_and_all_preserved_exports (test_right_angle.RightAngleGeometryTests.test_existing_envelope_defaults_models_and_all_preserved_exports) ... ok
test_metal_insertion_sweeps_and_black_base_interference_only_in_throat (test_right_angle.RightAngleGeometryTests.test_metal_insertion_sweeps_and_black_base_interference_only_in_throat) ... ok
test_missing_studio_overrides_are_rejected_and_path_probes_detect_obstruction (test_right_angle.RightAngleGeometryTests.test_missing_studio_overrides_are_rejected_and_path_probes_detect_obstruction) ... ok
test_print_layout_is_on_end_face_centered_and_samples_have_twelve_mm_gaps (test_right_angle.RightAngleGeometryTests.test_print_layout_is_on_end_face_centered_and_samples_have_twelve_mm_gaps) ... ok
test_rounded_bend_is_in_the_center_bridge_and_straight_sections_are_tangent (test_right_angle.RightAngleGeometryTests.test_rounded_bend_is_in_the_center_bridge_and_straight_sections_are_tangent) ... ok
test_samples_match_holder_socket_cutters_and_local_outer_wall (test_right_angle.RightAngleGeometryTests.test_samples_match_holder_socket_cutters_and_local_outer_wall) ... ok
test_all_fits_are_single_solids_with_required_walls_and_smaller_volume (test_right_angle_compact.CompactRightAngleTests.test_all_fits_are_single_solids_with_required_walls_and_smaller_volume) ... ok
test_all_previous_generated_files_remain_identical (test_right_angle_compact.CompactRightAngleTests.test_all_previous_generated_files_remain_identical) ... ok
test_centered_negative_x_face_layout_and_native_slice (test_right_angle_compact.CompactRightAngleTests.test_centered_negative_x_face_layout_and_native_slice) ... ok
test_closed_meshes_all_fits_and_cli_fit_skip_options (test_right_angle_compact.CompactRightAngleTests.test_closed_meshes_all_fits_and_cli_fit_skip_options) ... ok
test_complete_socket_cutters_are_rigid_translations_of_inverted_3e (test_right_angle_compact.CompactRightAngleTests.test_complete_socket_cutters_are_rigid_translations_of_inverted_3e) ... ok
test_insertion_sweeps_and_throat_only_interference_are_unchanged (test_right_angle_compact.CompactRightAngleTests.test_insertion_sweeps_and_throat_only_interference_are_unchanged) ... ok
test_tapers_remove_only_outer_rear_flanks_and_keep_the_central_bridge (test_right_angle_compact.CompactRightAngleTests.test_tapers_remove_only_outer_rear_flanks_and_keep_the_central_bridge) ... ok
test_all_fits_are_exact_reflections_and_retain_required_material (test_right_angle_inverted.InvertedRightAngleTests.test_all_fits_are_exact_reflections_and_retain_required_material) ... ok
test_all_fits_have_closed_meshes_and_cli_skip_flags_still_work (test_right_angle_inverted.InvertedRightAngleTests.test_all_fits_have_closed_meshes_and_cli_skip_flags_still_work) ... ok
test_all_previous_exports_including_current_3e_and_samples_are_preserved (test_right_angle_inverted.InvertedRightAngleTests.test_all_previous_exports_including_current_3e_and_samples_are_preserved) ... ok
test_both_curved_faces_dip_only_in_the_central_tangent_transition (test_right_angle_inverted.InvertedRightAngleTests.test_both_curved_faces_dip_only_in_the_central_tangent_transition) ... ok
test_each_complete_socket_is_rigidly_rotated_with_the_same_fit (test_right_angle_inverted.InvertedRightAngleTests.test_each_complete_socket_is_rigidly_rotated_with_the_same_fit) ... ok
test_layout_centers_the_mirrored_holder_on_the_negative_x_end (test_right_angle_inverted.InvertedRightAngleTests.test_layout_centers_the_mirrored_holder_on_the_negative_x_end) ... ok
test_measured_socket_axes_stay_parallel_and_wide_faces_reverse_roll (test_right_angle_inverted.InvertedRightAngleTests.test_measured_socket_axes_stay_parallel_and_wide_faces_reverse_roll) ... ok
test_project_and_slice_have_settings_clear_socket_cores_and_anchored_bridges (test_right_angle_inverted.InvertedRightAngleTests.test_project_and_slice_have_settings_clear_socket_cores_and_anchored_bridges) ... ok
test_both_metal_tips_follow_unobstructed_straight_insertion_paths (test_side_by_side.SideBySideGeometryTests.test_both_metal_tips_follow_unobstructed_straight_insertion_paths) ... ok
test_cli_custom_output_and_existing_skip_options (test_side_by_side.SideBySideGeometryTests.test_cli_custom_output_and_existing_skip_options) ... ok
test_delivered_stl_and_native_project (test_side_by_side.SideBySideGeometryTests.test_delivered_stl_and_native_project) ... ok
test_flat_centered_print_orientation_and_unchanged_defaults (test_side_by_side.SideBySideGeometryTests.test_flat_centered_print_orientation_and_unchanged_defaults) ... ok
test_minimum_enclosed_walls_and_inter_lane_separation (test_side_by_side.SideBySideGeometryTests.test_minimum_enclosed_walls_and_inter_lane_separation) ... ok
test_previous_curved_model_matches_preserved_step (test_side_by_side.SideBySideGeometryTests.test_previous_curved_model_matches_preserved_step) ... ok
test_two_opposite_facing_lanes_and_independent_blind_stops (test_side_by_side.SideBySideGeometryTests.test_two_opposite_facing_lanes_and_independent_blind_stops) ... ok
test_valid_single_solid_at_requested_dimensions (test_side_by_side.SideBySideGeometryTests.test_valid_single_solid_at_requested_dimensions) ... ok
test_winning_socket_dimensions_and_throat_transition (test_side_by_side.SideBySideGeometryTests.test_winning_socket_dimensions_and_throat_transition) ... ok

----------------------------------------------------------------------
Ran 71 tests in 397.972s

OK
Final exports match the validated project mesh; updated geometry reports and previews.
