hbmartin/usb-c-cable-bracelet-double-sided-connector/(commit log)

2026-10-17 combined 3mf files
    [all_connectors.3mf, all_connectors_A1.3mf, all_connectors_A1_PLA.3mf]
2026-10-18 Add compact connector variants and validated A1 print projects
    Generate the compact #3, #5, and #9 retainers and preserve their exports.
    Add the curved #3B, side-by-side #3C, and curved counter-angled #3D
    press-fit variants with previews, manifests, and A1 PLA print projects.
    Validate CAD geometry, socket insertion paths, and sliced toolpaths.
    Preserve custom strength settings when Bambu Studio imports the #3D
    project and reject missing process-override metadata in regression tests.
    Document the winning #3 fit and each variation's loading and printing.
    Validation: uv run --locked python -m unittest -v (40 tests passed).
    Model: gpt-6.1-sol
    Reasoning effort: xhigh
    Thread ID: 01a14772-932e-7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
    [03_compact_press_fit.step, 03_compact_press_fit.stl, 03b_curved_press_fit_15deg.step, 03b_curved_press_fit_15deg.stl, 03c_side_by_side_press_fit.step, 03c_side_by_side_press_fit.stl, 03d_curved_side_by_side_press_fit_15deg.step, 03d_curved_side_by_side_press_fit_15deg.stl]
2026-10-21 Add right-angle #3E holders, inverted bend, and validated A1 projects
    Add the measured right-angle plug envelope, three retaining-mouth fits,
    straight fit samples, and the corrected 15-degree bend between socket lanes.
    Add the inverted #3E variant while preserving existing geometry and defaults.
    Include STEP/STL exports, individual and combined A1 print projects, CAD
    previews, plate maps, geometry and toolpath validation, and README commands.
    Preserve the original-axis exports and the referenced #3D project backup.
    Validation: 64 tests passed; preserved export hashes and final slice checks pass.
    Thread ID: 01a14772-932e-7da1-845b-48528ffeeeac
    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
    [03e_fit_sample_firm.step, 03e_fit_sample_firm.stl, 03e_fit_sample_gentle.step, 03e_fit_sample_gentle.stl, 03e_fit_sample_standard.step, 03e_fit_sample_standard.stl, 03e_inverted_right_angle_side_by_side_standard.step, 03e_inverted_right_angle_side_by_side_standard.stl]
2026-11-08 combined version
    [03f_compact_tapered_right_angle_standard.step, 03f_compact_tapered_right_angle_standard.stl, compact_tapered_press_fit_3F_A1_PLA.3mf]
